jrvrcd/all-in-one/README.md

Ce sujet est decrit dans l'article blablabla du Blog home assistant
