jrvrcd/all-in-one/BOM.xlsx

ID | Name | Designator | Footprint | Quantity | Manufacturer Part
1 | HDR-F-2.54_1x2 | H1 | HDR-F-2.54_1X2 | 1
2 | LED-TH-5mm | LED25,LED32,LED11 | LED-TH_BD5.0_RED | 3 | 333-2SURD/S530-A3
3 | BS170 | Q11 | TO 92 | 1 | BS170
4 | AC-DC PS 5V/3W | A1 | hi-link | 1 | AC-05-3
5 | 100u | C01 | CAP-D8.0-F3.5 | 1
6 | 0.1u | C02 | RAD-0.3 | 1
7 | WJ25C-B-7.62-3P-13-00A | CN1 | CONN-TH_3P-P7.62_WJ25C-B-7.62-3P | 1 | WJ25C-B-7.62-3P
8 | 1N4007-B | D1,D2,D3,D4 | DO-41_BD2.4-L4.7-P8.70-D0.9-RD | 4 | 1N4007-B
9 | ESP32-WROOM-32 | E31 | ESP32-WROOM-32 | 1
10 | 3.5MM STEREO 5 POLE PCB JRV | J21,J22,J23,J24 | 3.5MM STEREO 5 POLE PCB | 4 | 913-1021
11 | HDR-M-2.54_1x3 | J31 | HDR-M-2.54_1X3 | 1
12 | HDR-M-2.54_1x4 | J32 | HDR-M-2.54_1X4 | 1
13 | CONN-TH_2P-P5.00 | P12 | CONN-TH_2P-P5.00 | 1
14 | ADS1115 | P21,P23 | ADS1115 BREAKOUT BOARD NO HOLES | 2
15 | 10k | R14,R42 | R_AXIAL-0.3 | 2
16 | 1k | R15,R413 | R_AXIAL-0.3 | 2
17 | 4.7k | R16,R34,R35,R36 | R_AXIAL-0.3 | 4
18 | 470 | R32,R33 | R_AXIAL-0.3 | 2
19 | 220 | R47 | R_AXIAL-0.3 | 1
20 | 120k | R48,R410 | RC07 | 2
21 | LTV-814 | U13 | DIP-4_L6.4-W4.6-P2.54-LS7.6-BL | 1 | LTV-814
22 | JSY-MK-194 | U31 | JSY-MK-194 | 1 | JSY-MK-194
23 | BPC-817 B | U46 | DIP-4_L6.4-W4.6-P2.54-LS7.6-BL | 1 | BPC-817
24 | Bta41-600B | U47 | BTA41 | 1
25 | MOC3021 | U48 | MOC3021-DIP6 | 1 | MOC3021
