jrvrcd/all-in-one/boite.stl

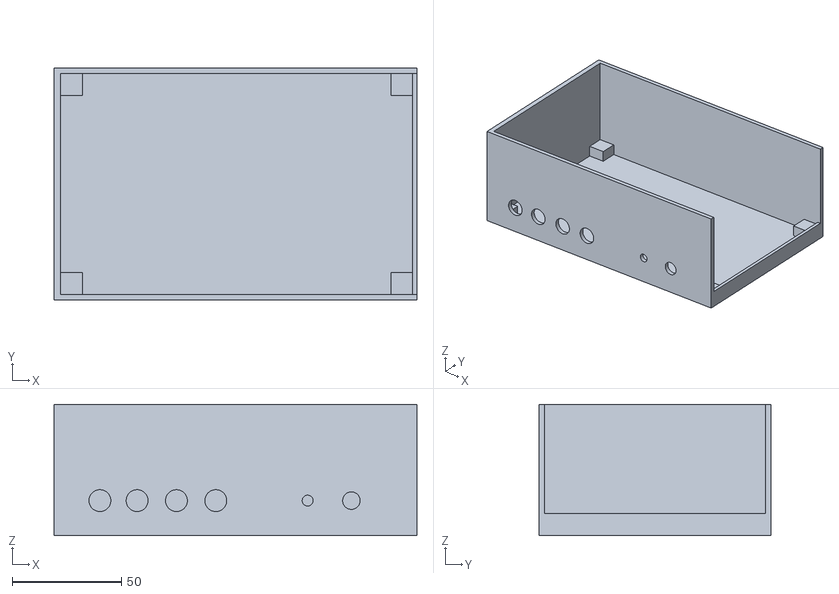
[picture p1: CAD file, 2025-01-19]
boite.stl
166.0 x 106.0 x 60.0
