jrvrcd/all-in-one/protection_écran_lcd_4X20.stl

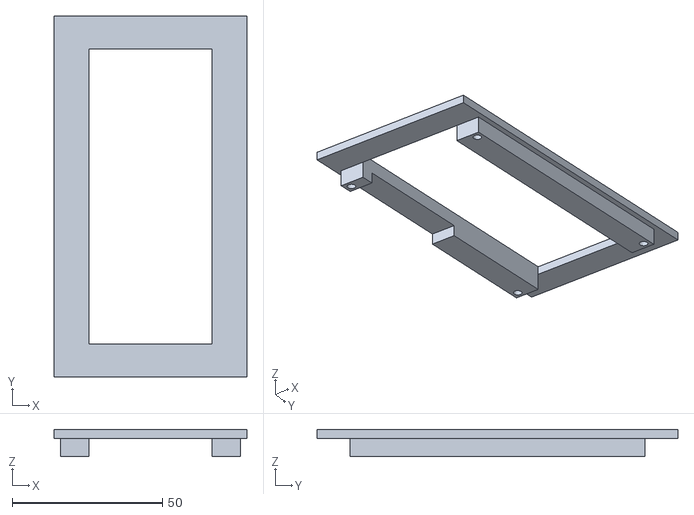
[picture p2: CAD file, 2025-01-19]
protection_écran_lcd_4X20.stl
64.0 x 120.0 x 9.00
