jrvrcd/all-in-one/couvercle v4.3-Body.stl

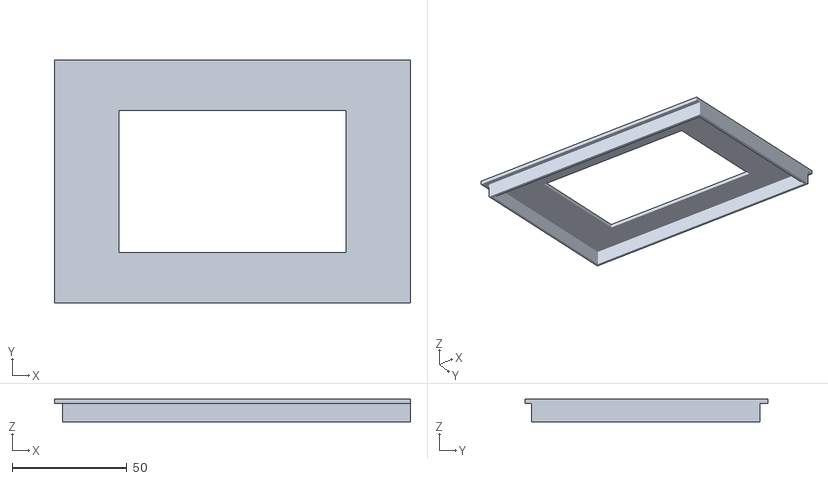
[picture p3: CAD file, 2025-01-19]
couvercle v4.3-Body.stl
155.0 x 106.0 x 10.0
