jrvrcd/all-in-one/(list of files, drawings)

Other design files:
PCB_PCB_ALL-IN-ONE_2025-03-16.json
